rough-rat/owadzium/README.md

# owadzium

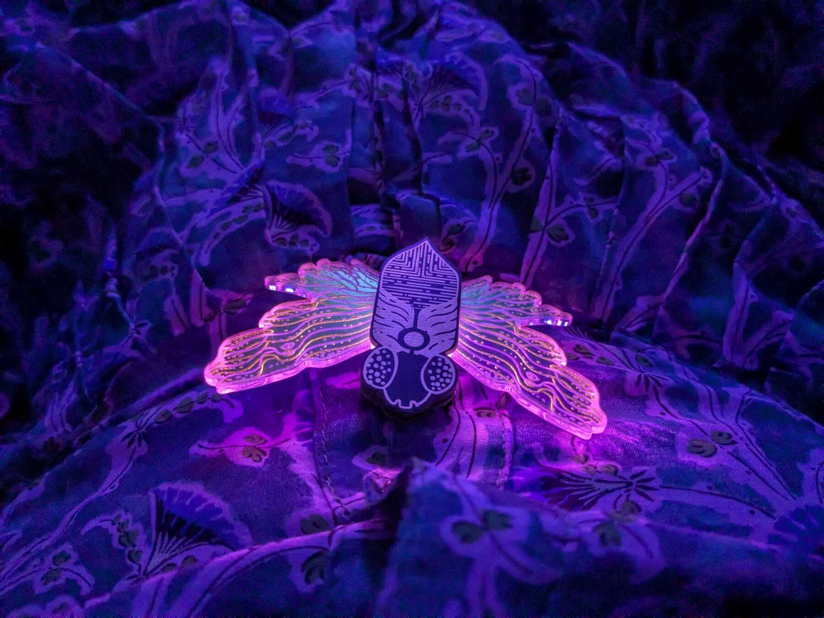
[picture p1: main.jpg]
photo of the complete badge
