rough-rat/owadzium/reference/LEDS.md

SMD,1.7x0.6mm:

https://jlcpcb.com/partdetail/CHONGTIAN-CT_1706UFCP11/C52675980 - pink
https://jlcpcb.com/partdetail/8401797-BL_HGE38E_AVTRC/C7421381 - green
https://jlcpcb.com/partdetail/Harvatek-XN0603UWC/C48678155 - white cold
