rough-rat/owadzium/podwozium/podwozium.kicad_pcb

## KiCad design podwozium/podwozium.kicad_pcb (2026-10-24)

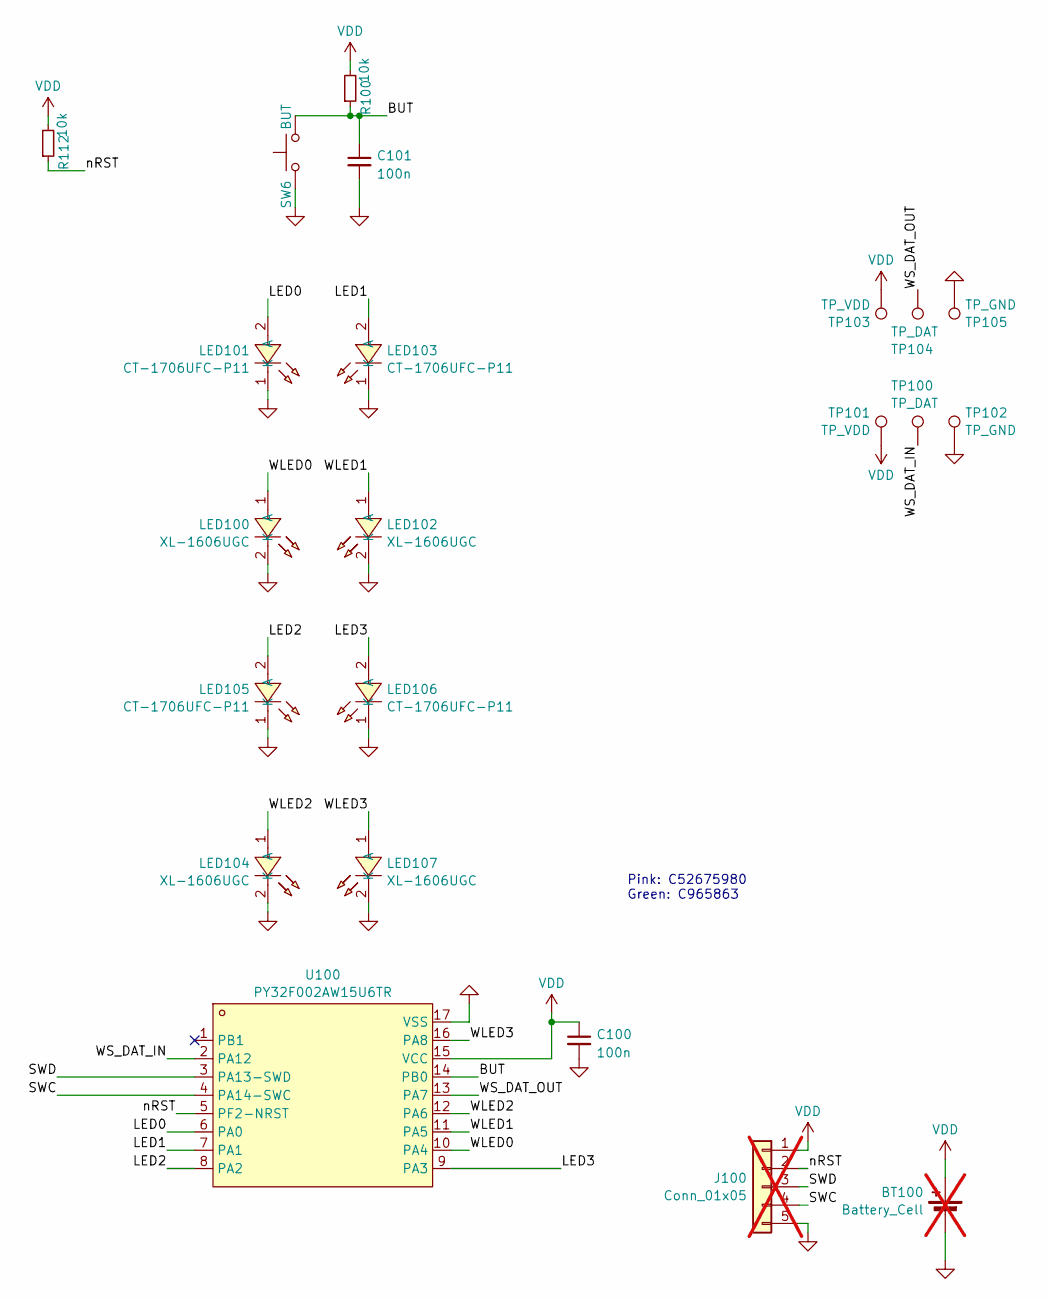
[picture p2: schematic podwozium.kicad_sch]

Parts:
BT100: Battery_Cell; BatteryHolder_Keystone_1060_1x2032; LCSC DNP; not fitted
C100, C101: 100n; C_0402_1005Metric; LCSC C1525
J100: Conn_01x05; PinHeader_1x05_P1.27mm_Vertical; LCSC DNP; not fitted
LED100, LED102, LED104, LED107: XL-1606UGC; LED-SMD_L1.7-W1.1-R-RD_GREEN; LCSC C965863
LED101, LED103, LED105, LED106: CT-1706UFC-P11; LED-SMD_L1.7-W1.1-RD_RED; MPN CT-1706UFC-P11; LCSC C52675980
R100, R112: 10k; R_0402_1005Metric; LCSC C25744
SW6: BUT; SW_SPST_TL3342; LCSC C7470214
TP100, TP104: TP_DAT; TestPoint_Pad_1.0x1.0mm
TP101, TP103: TP_VDD; TestPoint_Pad_1.0x1.0mm
TP102, TP105: TP_GND; TestPoint_Pad_1.0x1.0mm
U100: PY32F002AW15U6TR; TQFN-16_L3.0-W3.0-P0.50-BL-EP1.7; LCSC C5291740

Connections:
/BUT: C101.1, R100.1, SW6.1, U100.14 (PB0)
/LED0: LED101.2 (A), U100.6 (PA0)
/LED1: LED103.2 (A), U100.7 (PA1)
/LED2: LED105.2 (A), U100.8 (PA2)
/LED3: LED106.2 (A), U100.9 (PA3)
/SWC: J100.4, U100.4 (PA14-SWC)
/SWD: J100.3, U100.3 (PA13-SWD)
/WLED0: LED100.1 (A), U100.10 (PA4)
/WLED1: LED102.1 (A), U100.11 (PA5)
/WLED2: LED104.1 (A), U100.12 (PA6)
/WLED3: LED107.1 (A), U100.16 (PA8)
/WS_DAT_IN: TP100.1 (1_1), U100.2 (PA12)
/WS_DAT_OUT: TP104.1 (1_1), U100.13 (PA7)
/nRST: J100.2, R112.1, U100.5 (PF2-NRST)
GND: BT100.2 (-), C100.2, C101.2, J100.5, LED100.2 (K), LED101.1 (K), LED102.2 (K), LED103.1 (K), LED104.2 (K), LED105.1 (K), LED106.1 (K), LED107.2 (K), SW6.2, TP102.1 (1_1), TP105.1 (1_1), U100.17 (VSS)
VDD: BT100.1 (+), C100.1, J100.1, R100.2, R112.2, TP101.1 (1_1), TP103.1 (1_1), U100.15 (VCC)

Notes on the sheet:
Pink: C52675980 Green: C965863

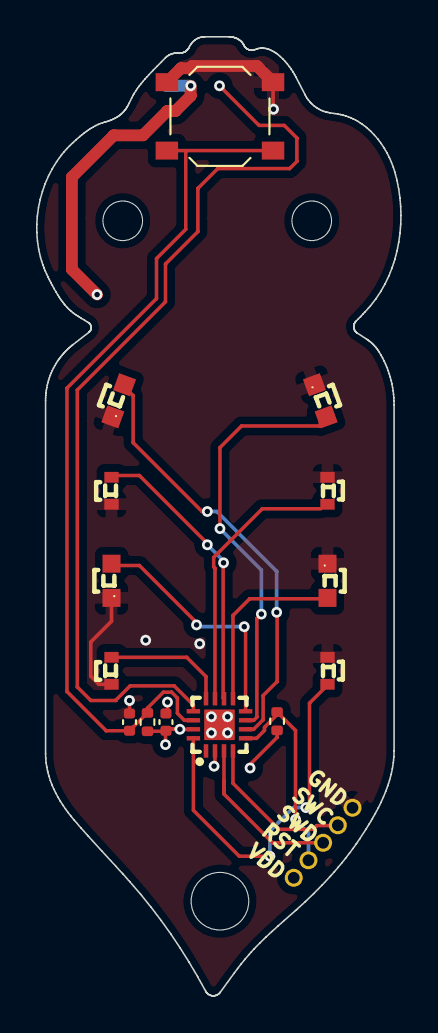
[picture p3: board podwozium.kicad_pcb from above]

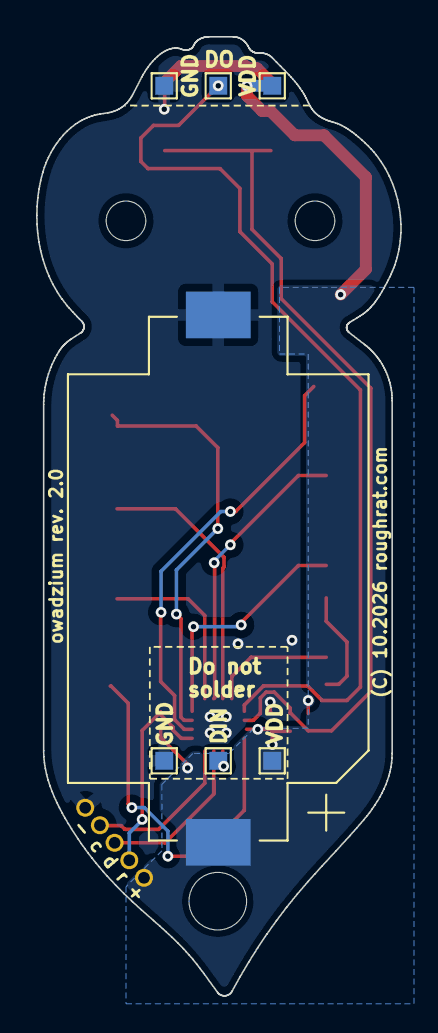
[picture p4: board podwozium.kicad_pcb from below]

Board: 2 copper layers, 20.2 x 53.3 mm, 22 parts (7 on the bottom side), 16 nets.
