rough-rat/owadzium/(commit log)

2026-07-28 rev 1.0
    [owadzium.kicad_pcb, owadzium.kicad_sch, podwozium.kicad_pcb, podwozium.kicad_sch]
2026-10-21 add files, firmware
    [owadzium.kicad_pcb, owadzium.kicad_sch, podwozium.kicad_pcb, podwozium.kicad_sch]
2026-10-24 new owadzium order
    [podwozium.kicad_pcb, podwozium.kicad_sch]
